Philippe12/HorseSense/horsesense.xlsx

Prj: | horsesense.xml |  |  |  |  |  | Board Qty: | 100
Co.: |  |  |  |  |  |  | Unit Cost: | €27.40
Prj date: | 2025-10-19T16:21:12+0200 |  |  |  |  |  | Total Cost: | €2740.28 |  |  |  |  | €3041.39 | 29 of 29 parts found |  |  |  |  | €2652.00 | 26 of 29 parts found
$ date: | 2025-10-19 16:36:01
Global Part Info |  |  |  |  |  |  |  |  | Digi-Key |  |  |  |  |  | Mouser
Refs | Value | Desc | Footprint | Manf | Manf# | Qty | Unit$ | Ext$ | Avail | Purch | Unit$ | MOQ | Ext$ | Cat# | Avail | Purch | Unit$ | MOQ | Ext$ | Cat#
C1,C3,C19,C23,C25,C30,C32 | 100n | Unpolarized capacitor | C_0805_2012Metric |  | CL21B104KBCNNNC | 700 | €0.005 | €3.50 | 1496000 |  | €0.006 | 1 | €3.90 | 1276-1003-1-ND (https://www.digikey.com/en/products/detail/samsung-electro-mechanics/CL21B104KBCNNNC/3886661) | 1526592 |  | €0.005 | 1 | €3.50 | 187-CL21B104KBCNNNC (https://eu.mouser.com/ProductDetail/Samsung-Electro-Mechanics/CL21B104KBCNNNC?qs=349EhDEZ59pEfpnm5yBEmQ%3D%3D)
C2 | 2.2µ | Unpolarized capacitor | C_0805_2012Metric |  | CL21B225KAFNNNE | 100 | €0.035 | €3.50 | 423908 |  | €0.035 | 1 | €3.54 | 1276-2954-1-ND (https://www.digikey.com/en/products/detail/samsung-electro-mechanics/CL21B225KAFNNNE/3888612) | 33568 |  | €0.035 | 1 | €3.50 | 187-CL21B225KAFNNNE (https://eu.mouser.com/ProductDetail/Samsung-Electro-Mechanics/CL21B225KAFNNNE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)
C4,C9,C10,C12,C18,C22,C33 | 10µ | Unpolarized capacitor | C_0805_2012Metric |  | CL21B106KPQNNNE | 700 | €0.021 | €14.94 | 26373 |  | €0.021 | 1 | €14.94 | 1276-1764-1-ND (https://www.digikey.com/en/products/detail/samsung-electro-mechanics/CL21B106KPQNNNE/3887422) | 162739 |  | €0.041 | 1 | €28.70 | 187-CL21B106KPQNNNE (https://eu.mouser.com/ProductDetail/Samsung-Electro-Mechanics/CL21B106KPQNNNE?qs=yOVawPpwOwnw0R5uMCgpNQ%3D%3D)
C5,C8,C14-C17,C37 | 1µ | Unpolarized capacitor | C_0805_2012Metric |  | CL21B105KAFNFNE | 700 | €0.017 | €11.90 | 94499 |  | €0.018 | 1 | €12.89 | 1276-2926-1-ND (https://www.digikey.com/en/products/detail/samsung-electro-mechanics/CL21B105KAFNFNE/3888584) | 77582 |  | €0.017 | 1 | €11.90 | 187-CL21B105KAFNFNE (https://eu.mouser.com/ProductDetail/Samsung-Electro-Mechanics/CL21B105KAFNFNE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)
C6,C7,C24 | 22µ | Unpolarized capacitor | C_0805_2012Metric |  | GRM21BZ71A226ME15L | 300 | €0.100 | €30.00 | 790570 |  | €0.109 | 1 | €32.82 | 490-GRM21BZ71A226ME15LCT-ND (https://www.digikey.com/en/products/detail/murata-electronics/GRM21BZ71A226ME15L/13904953) | NonStk |  | €0.100 | 1 | €30.00 | 81-GRM21BZ71A226ME5L (https://eu.mouser.com/ProductDetail/Murata-Electronics/GRM21BZ71A226ME15L?qs=Ey7%2FXF42M3ejDq7iqlmWWw%3D%3D)
C11 | 4.7µ | Unpolarized capacitor | C_0805_2012Metric |  | C2012X7R1A475KT000N | 100 | €0.068 | €6.81 | 171009 |  | €0.068 | 1 | €6.81 | 445-7591-1-ND (https://www.digikey.com/en/products/detail/tdk-corporation/C2012X7R1A475K125AC/2733026) | NonStk |  |  |  |  | N/A (https://eu.mouser.com/ProductDetail/TDK/C2012X7R1A475KT000N?qs=chTDxNqvsynaOKmsupj4Xw%3D%3D)
C13 | 47n | Unpolarized capacitor | C_0805_2012Metric |  | 0805B473K500NT | 100 | €0.151 | €15.10 | 2999 |  | €0.839 | 1 | €83.89 | 1763-0805B473K500NTCT-ND (https://www.digikey.com/en/products/detail/knowles-novacap/0805B473K500NT/25702069) | 1310 |  | €0.151 | 1 | €15.10 | 767-0805B473K500NT (https://eu.mouser.com/ProductDetail/Knowles-Novacap/0805B473K500NT?qs=7wMBv%2Ftbz9JoQrUAzLtdOA%3D%3D)
C20,C21 | 33p | Unpolarized capacitor | C_0805_2012Metric |  | CC0805JRNPO9BN330 | 200 | €0.023 | €4.60 | 36849 |  | €0.026 | 1 | €5.27 | 311-1105-1-ND (https://www.digikey.com/en/products/detail/yageo/CC0805JRNPO9BN330/302839) | NonStk |  | €0.023 | 1 | €4.60 | 603-CC805JRNPO9BN330 (https://eu.mouser.com/ProductDetail/YAGEO/CC0805JRNPO9BN330?qs=AgBp2OyFlx9F4YPNsCGomw%3D%3D)
C28,C29 | 100p | Unpolarized capacitor | C_0805_2012Metric |  | GRM2165C1H101JA01D | 200 | €0.033 | €6.60 | 498356 |  | €0.037 | 1 | €7.44 | 490-1615-1-ND (https://www.digikey.com/en/products/detail/murata-electronics/GRM2165C1H101JA01D/586800) | 39028 |  | €0.033 | 1 | €6.60 | 81-GRM40C101J50D (https://eu.mouser.com/ProductDetail/Murata-Electronics/GRM2165C1H101JA01D?qs=IBLLvG%2FZGEX76Y%2F8Q9SJHQ%3D%3D)
C31 | 10n | Unpolarized capacitor | C_0805_2012Metric |  | CL21B103KBANNNC | 100 | €0.006 | €0.59 | 668421 |  | €0.006 | 1 | €0.59 | 1276-1015-1-ND (https://www.digikey.com/en/products/detail/samsung-electro-mechanics/CL21B103KBANNNC/3886673) | 369969 |  | €0.007 | 1 | €0.70 | 187-CL21B103KBANNNC (https://eu.mouser.com/ProductDetail/Samsung-Electro-Mechanics/CL21B103KBANNNC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)
D1-D3 | CT DBLP31.12-6C5D-56-J6U6-20-R18 | Light emitting diode | CTDBLP31126C5D56J6U620R18 |  | CT DBLP31.12-6C5D-56-J6U6-20-R18 | 300 | €0.568 | €170.40 | 5093 |  | €0.612 | 1 | €183.46 | 475-CTDBLP31.12CT-ND (https://www.digikey.com/en/products/detail/ams-osram-usa-inc/CT-DBLP31-12-6C5D-56-J6U6-20-R18/17628909) | 3994 |  | €0.568 | 1 | €170.40 | 720-CTDB6C5D56J6U620 (https://eu.mouser.com/ProductDetail/ams-OSRAM/CT-DBLP31.12-6C5D-56-J6U6-20-R18?qs=vLWxofP3U2xgbqKYEOstuw%3D%3D)
D4,D6 | VEMD8080 |  | XDCR_VEMD8080 | VISHAY | VEMD8080 (https://www.vishay.com/docs/84565/vemd8080.pdf) | 200 | €0.869 | €173.80 | 4541 |  | €1.162 | 1 | €232.48 | VEMD8080CT-ND (https://www.digikey.com/en/products/detail/vishay-semiconductor-opto-division/VEMD8080/8602378) | 37930 |  | €0.869 | 1 | €173.80 | 78-VEMD8080 (https://eu.mouser.com/ProductDetail/Vishay-Semiconductors/VEMD8080?qs=F5EMLAvA7IBCchs2bw9l%2Fw%3D%3D)
J1 | USB4105-GF-A-120 | USB 2.0-only 14P Type-C Receptacle connector | USB_C_Receptacle_GCT_USB4105-xx-A_16P_TopMnt_Horizontal |  | USB4105-GF-A-120 (https://www.usb.org/sites/default/files/documents/usb_type-c.zip) | 100 | €0.443 | €44.30 | 17061 |  | €0.519 | 1 | €51.94 | 2073-USB4105-GF-A-120CT-ND (https://www.digikey.com/en/products/detail/gct/USB4105-GF-A-120/14559037) | 82889 |  | €0.443 | 1 | €44.30 | 640-USB4105-GF-A-120 (https://eu.mouser.com/ProductDetail/GCT/USB4105-GF-A-120?qs=QNEnbhJQKva%252Bjxw%2FpEjDhQ%3D%3D)
J3 | 73412-0110 | coaxial connector (BNC, SMA, SMB, SMC, Cinch/RCA, LEMO, ...) | U.FL_Molex_MCRF_73412-0110_Vertical |  | 73412-0110 | 100 | €0.483 | €48.30 | 110105 |  | €0.533 | 1 | €53.26 | WM5587CT-ND (https://www.digikey.com/en/products/detail/molex/0734120110/1894611) | NonStk |  | €0.483 | 1 | €48.30 | 538-73412-0110 (https://eu.mouser.com/ProductDetail/Molex/73412-0110?qs=NlNVDDZd7xQHV8e0ilpSdQ%3D%3D)
L1 | 1µ | Inductor | L_0805_2012Metric |  | LQM21PH1R0NGCD | 100 | €0.132 | €13.20 | 7490 |  | €0.143 | 1 | €14.28 | 490-18468-1-ND (https://www.digikey.com/en/products/detail/murata-electronics/LQM21PH1R0NGCD/10135259) | 14563 |  | €0.132 | 1 | €13.20 | 81-LQM21PH1R0NGCD (https://eu.mouser.com/ProductDetail/Murata-Electronics/LQM21PH1R0NGCD?qs=17u8i%2FzlE8%252BENrjyNDhWgQ%3D%3D)
L2 | 68nH | Inductor with iron core, small symbol | L_0805_2012Metric |  | MLF2012D68NMTD25 | 100 | €0.092 | €9.20 | 5061 |  | €0.099 | 1 | €9.86 | 445-16980-1-ND (https://www.digikey.com/en/products/detail/tdk-corporation/MLF2012D68NMTD25/4743105) | 4199 |  | €0.092 | 1 | €9.20 | 810-MLF2012D68NMTD25 (https://eu.mouser.com/ProductDetail/TDK/MLF2012D68NMTD25?qs=u4%252BEJ9urDATSIFVN0NofiA%3D%3D)
MT1 | ICM-42670-P |  | XDCR_ICM-42670-P | TDK InvenSense | ICM-42670-P (https://invensense.tdk.com/download-pdf/icm-42670-p-datasheet/) | 100 | €2.220 | €222.00 | 8770 |  | €2.534 | 1 | €253.37 | 1428-ICM-42670-PCT-ND (https://www.digikey.com/en/products/detail/tdk-invensense/ICM-42670-P/14319524) | 7299 |  | €2.220 | 1 | €222.00 | 410-ICM-42670-P (https://eu.mouser.com/ProductDetail/TDK-InvenSense/ICM-42670-P?qs=iLbezkQI%252BsgK8sMF5V7fQQ%3D%3D)
R1,R2 | 5.1k | Resistor | R_0805_2012Metric |  | RK73H2ATTD5101F | 200 | €0.011 | €2.20 | 39708 |  | €0.015 | 1 | €2.95 | 2019-RK73H2ATTD5101FCT-ND (https://www.digikey.com/en/products/detail/koa-speer-electronics-inc/RK73H2ATTD5101F/10234175) | 39096 |  | €0.011 | 1 | €2.20 | 660-RK73H2ATTD5101F (https://eu.mouser.com/ProductDetail/KOA-Speer/RK73H2ATTD5101F?qs=qdbN2r920CXERR4aJasjig%3D%3D)
R3-R6,R29 | 10k | Resistor | R_0805_2012Metric |  | RK73H2ATTD1002F | 500 | €0.010 | €4.88 | 502198 |  | €0.010 | 1 | €4.88 | 2019-RK73H2ATTD1002FCT-ND (https://www.digikey.com/en/products/detail/koa-speer-electronics-inc/RK73H2ATTD1002F/10234111) | 1234351 |  | €0.011 | 1 | €5.50 | 660-RK73H2ATTD1002F (https://eu.mouser.com/ProductDetail/KOA-Speer/RK73H2ATTD1002F?qs=tLTLU8dkiwvc%2FyU3ERoqnw%3D%3D)
R7 | 0 | Resistor | R_0805_2012Metric |  | RC0805JR-7W0RL | 100 | €0.011 | €1.10 | 2116 |  | €0.016 | 1 | €1.59 | 13-RC0805JR-7W0RLCT-ND (https://www.digikey.com/en/products/detail/yageo/RC0805JR-7W0RL/12698815) | 43015 |  | €0.011 | 1 | €1.10 | 603-RC0805JR-7W0RL (https://eu.mouser.com/ProductDetail/YAGEO/RC0805JR-7W0RL?qs=tggtontpCXOvGhG2gs4kMQ%3D%3D)
SW1,SW2 | EVQ-P7A01P | Omron B3FS 6x6mm single pole normally-open tactile switch | SW_SPST_EVQP7A |  | EVQ-P7A01P (https://omronfs.omron.com/en_US/ecb/products/pdf/en-b3fs.pdf) | 200 | €0.160 | €32.00 | 45265 |  | €0.191 | 1 | €38.16 | P16763CT-ND (https://www.digikey.com/en/products/detail/panasonic-electronic-components/EVQ-P7A01P/4429447) | 15951 |  | €0.160 | 1 | €32.00 | 667-EVQP7A01P (https://eu.mouser.com/ProductDetail/Panasonic/EVQ-P7A01P?qs=rJ%252BziJWpysz7n3C20u6WAw%3D%3D)
U1 | MAX86141ENP+T |  | 21-100134_N201A2-1_MXM |  | MAX86141ENP+T | 100 | €6.210 | €621.00 | 4873 |  | €6.345 | 1 | €634.55 | MAX86141ENP+TCT-ND (https://www.digikey.com/en/products/detail/analog-devices-inc-maxim-integrated/MAX86141ENP-T/7804058) | 8768 |  | €6.210 | 1 | €621.00 | 700-MAX86141ENP+T (https://eu.mouser.com/ProductDetail/Analog-Devices-Maxim-Integrated/MAX86141ENP%2bT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)
U2 | TXB0304RUTR | 4-Bit Bidirectional Voltage-Level Translator, Auto Direction Sensing, 0.9 - 3.6V APort, 0.9 - 3.6V BPort, Active High Output Enable, Texas_PUQFN-12 | Texas_R-PUQFN-N12 |  | TXB0304RUTR (http://www.ti.com/lit/ds/symlink/txb0304.pdf) | 100 | €0.476 | €47.60 | 7676 |  | €0.513 | 1 | €51.32 | 296-29682-1-ND (https://www.digikey.com/en/products/detail/texas-instruments/TXB0304RUTR/2762235) | 29040 |  | €0.476 | 1 | €47.60 | 595-TXB0304RUTR (https://eu.mouser.com/ProductDetail/Texas-Instruments/TXB0304RUTR?qs=bhx7MkwkKU%252BRFcNlao4SmA%3D%3D)
U3 | BQ25601 | I2C Controlled 3A Single-Cell Battery Charger for High Input Voltage and Narrow Voltage DC Power Path Management, WQFN-32 | Texas_RTW_WQFN-24-1EP_4x4mm_P0.5mm_EP2.7x2.7mm_ThermalVias |  | BQ25601DRTWR (http://www.ti.com/lit/ds/symlink/bq25601.pdf) | 100 | €1.680 | €168.00 | 10132 |  | €1.814 | 1 | €181.42 | 296-BQ25601DRTWRCT-ND (https://www.digikey.com/en/products/detail/texas-instruments/BQ25601DRTWR/9597826) | 977 |  | €1.680 | 1 | €168.00 | 595-BQ25601DRTWR (https://eu.mouser.com/ProductDetail/Texas-Instruments/BQ25601DRTWR?qs=w%2Fv1CP2dgqrIFVXOqACIAg%3D%3D)
U4 | XC6210B332MR | 700mA, Low Drop-out Voltage Regulator, Fixed Output 3.3V, SOT-23-5 | SOT-23-5 |  | XC6210B332MR (https://www.torexsemi.com/file/xc6210/XC6210.pdf) | 100 | €0.480 | €47.98 | 57377 |  | €0.480 | 1 | €47.98 | 893-1075-1-ND (https://www.digikey.com/en/products/detail/torex-semiconductor-ltd/XC6210B332MR-G/2138119) | NonStk |  |  |  |  | N/A (https://eu.mouser.com/ProductDetail/Torex-Semiconductor/XC6210B332MR?qs=TiOZkKH1s2RnKp%252BMGbUSuQ%3D%3D)
U5 | XC6210B182MR | 700mA, Low Drop-out Voltage Regulator, Fixed Output 3.3V, SOT-23-5 | SOT-23-5 |  | XC6210B182MR (https://www.torexsemi.com/file/xc6210/XC6210.pdf) | 100 | €0.480 | €47.98 | 5294 |  | €0.480 | 1 | €47.98 | 893-1072-1-ND (https://www.digikey.com/en/products/detail/torex-semiconductor-ltd/XC6210B182MR-G/2138116) | NonStk |  |  |  |  | N/A (https://eu.mouser.com/ProductDetail/Torex-Semiconductor/XC6210B182MR?qs=TiOZkKH1s2TLQjPgSN8%2F1g%3D%3D)
U6 | LC76GPAMD |  | Package | Quectel | LC76GPAMD (https://mm.digikey.com/Volume0/opasdata/d220001/medias/docus/7133/Quectel_LC76G_Series_GNSS_Specification_V1.1-1-1.pdf) | 100 | €5.400 | €540.00 | 1782 |  | €5.826 | 1 | €582.55 | 2958-LC76GPAMDCT-ND (https://www.digikey.com/en/products/detail/quectel/LC76GPAMD/21272484) | 1212 |  | €5.400 | 1 | €540.00 | 277-LC76GPAMD (https://eu.mouser.com/ProductDetail/Quectel/LC76GPAMD?qs=vvQtp7zwQdMfDuCTmjRUww%3D%3D)
U7 | AP22804AW5-7 | Current limited 2.5A power switch, single channel, SOT-23-5 | SOT-23-5 |  | AP22804AW5-7 (https://www.diodes.com/assets/Datasheets/AP22804_14.pdf) | 100 | €0.158 | €15.80 | 237574 |  | €0.170 | 1 | €17.05 | AP22804AW5-7DICT-ND (https://www.digikey.com/en/products/detail/diodes-incorporated/AP22804AW5-7/6602435) | 43139 |  | €0.158 | 1 | €15.80 | 621-AP22804AW5-7 (https://eu.mouser.com/ProductDetail/Diodes-Incorporated/AP22804AW5-7?qs=lqAf%2FiVYw9hgcUuNhFapmA%3D%3D)
U9 | ESP32-S3-WROOM-1-N16R8 | RF Module, ESP32-S3 SoC, Wi-Fi 802.11b/g/n, Bluetooth, BLE, 32-bit, 3.3V, onboard antenna, SMD | ESP32-S3-WROOM-1 |  | ESP32-S3-WROOM-1-N16R8 (https://www.espressif.com/sites/default/files/documentation/esp32-s3-wroom-1_wroom-1u_datasheet_en.pdf) | 100 | €4.330 | €433.00 | 12045 |  | €4.602 | 1 | €460.21 | 5407-ESP32-S3-WROOM-1-N16R8CT-ND (https://www.digikey.com/en/products/detail/espressif-systems/ESP32-S3-WROOM-1-N16R8/16162642) | 9029 |  | €4.330 | 1 | €433.00 | 356-ESP32S3WRM1N16R8 (https://eu.mouser.com/ProductDetail/Espressif-Systems/ESP32-S3-WROOM-1-N16R8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)
 | Used currency rates: |  |  |  |  |  | Total Purchase: | €0.00 | Buy here (https://www.digikey.com/ordering/shoppingcart) |  |  |  | €0.00 |  | Buy here (https://mouser.com/bom/) |  |  |  | €0.00
 | EUR(€)/USD($): | 0.9279881218 |  |  |  |  | Purchase description:
KiCost® v1.1.19
