Philippe12/HorseSense/horsesense.kicad_pcb

## KiCad design horsesense.kicad_pcb (2026-08-13)

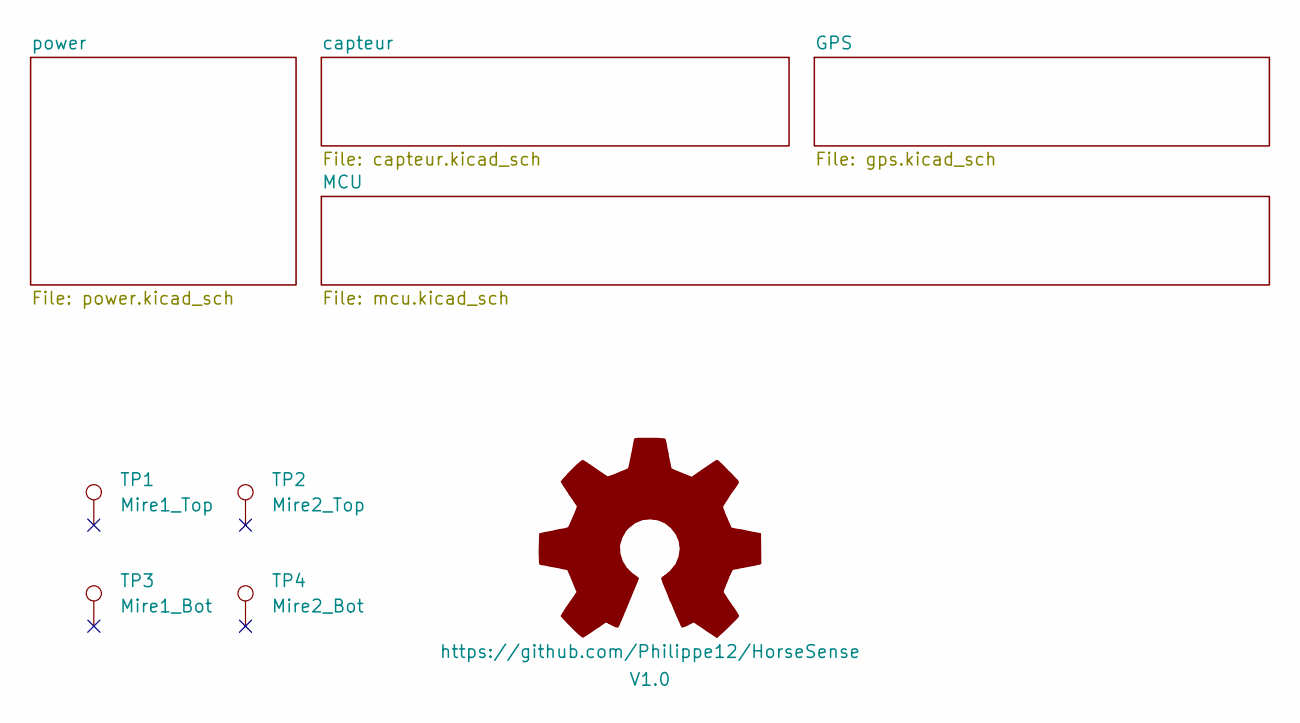
[picture p1: schematic horsesense.kicad_sch]

Parts:
SYM1: https://github.com/Philippe12/HorseSense; OSHW-Symbol_13.4x12mm_SilkScreen
TP1: Mire1_Top; TestPoint_Pad_D1.0mm
TP2: Mire2_Top; TestPoint_Pad_D1.0mm
TP3: Mire1_Bot; TestPoint_Pad_D1.0mm
TP4: Mire2_Bot; TestPoint_Pad_D1.0mm

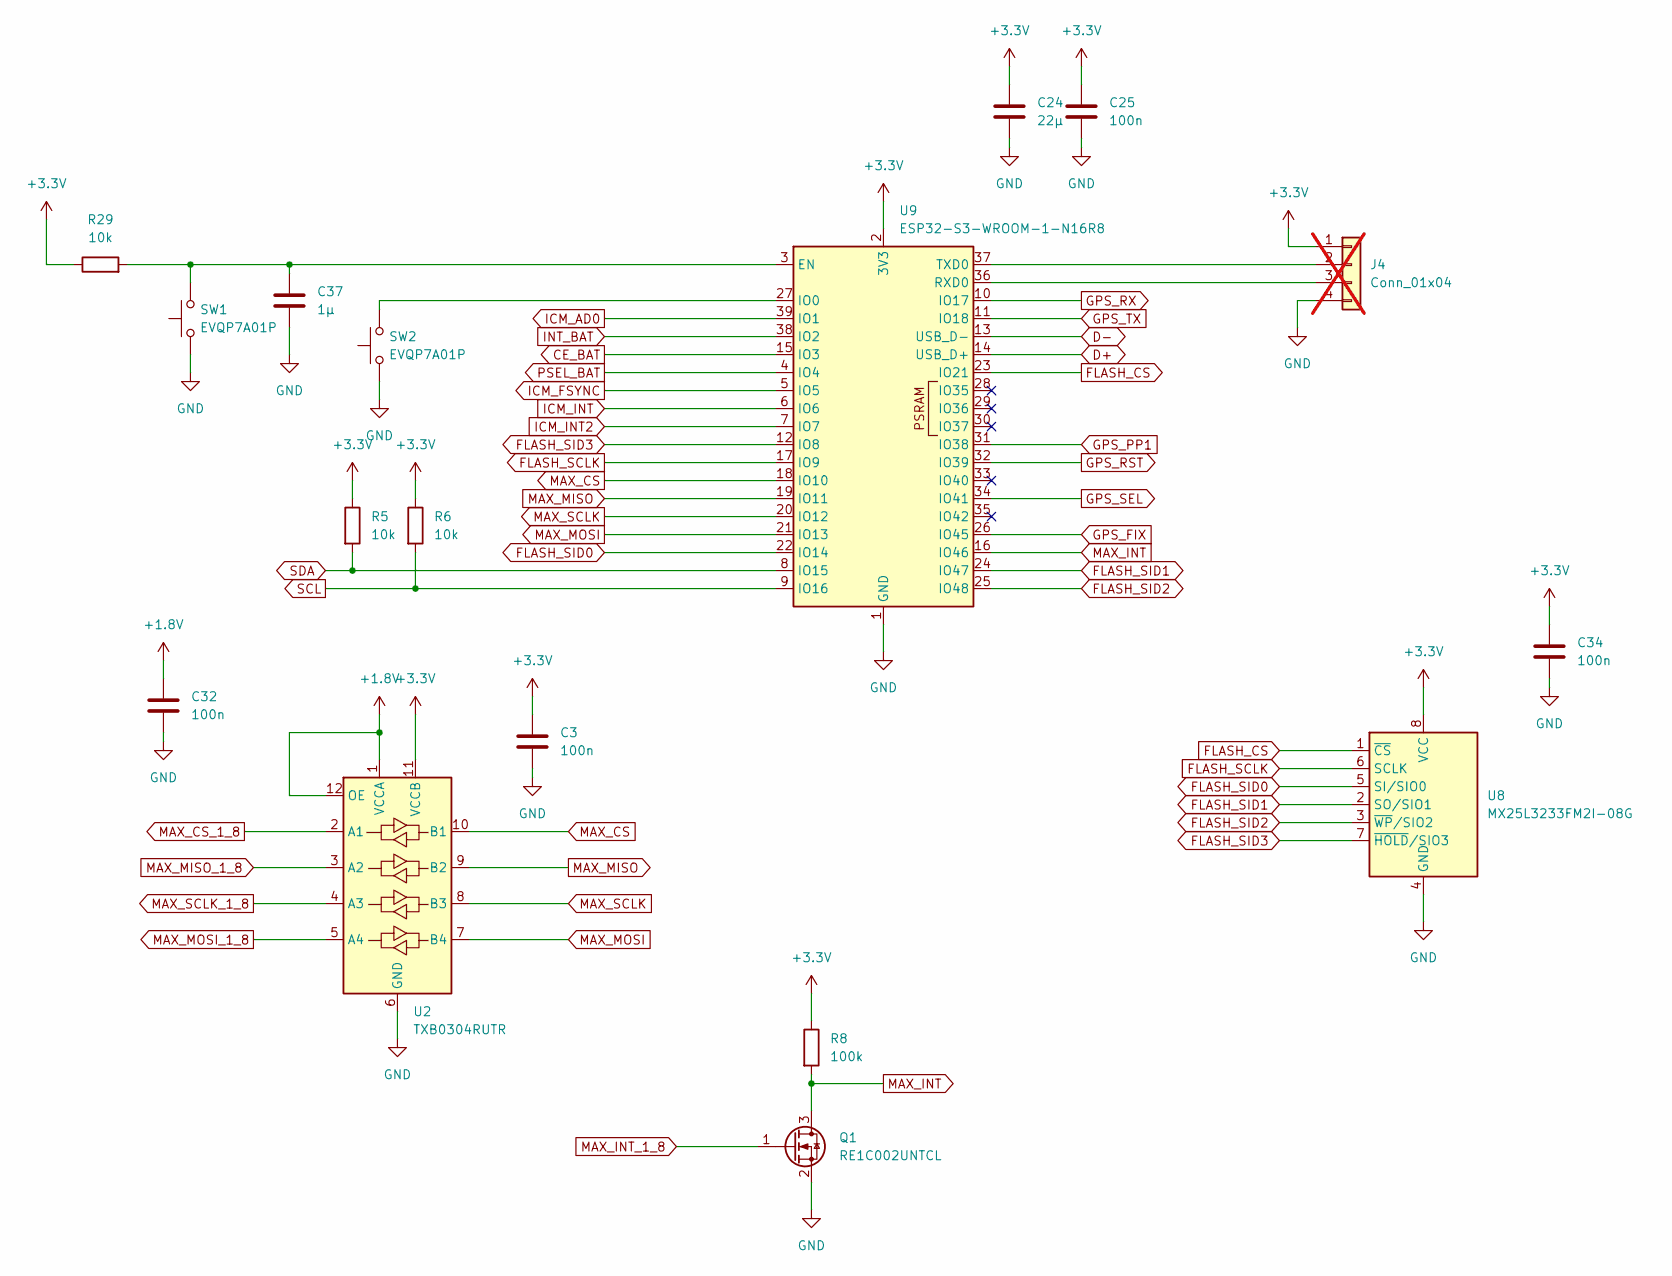
[picture p2: schematic mcu.kicad_sch, HorseSense]

Parts:
C3, C25, C32, C34: 100n; C_0805_2012Metric; JLCPCB Part # C1711
C24: 22µ; C_0805_2012Metric; JLCPCB Part # C907991
C37: 1µ; C_0805_2012Metric; JLCPCB Part # C1712
J4: Conn_01x04; PinHeader_1x04_P1.27mm_Vertical; not fitted
Q1: RE1C002UNTCL; SOT-416; JLCPCB Part # C509959
R5, R6, R29: 10k; R_0805_2012Metric; JLCPCB Part # C276215
R8: 100k; R_0805_2012Metric; JLCPCB Part # C25271
SW1, SW2: EVQP7A01P; SW_SPST_EVQP7A; JLCPCB Part # C79167
U2: TXB0304RUTR; Texas_R-PUQFN-N12; JLCPCB Part # C69598
U8: MX25L3233FM2I-08G; SOIC-8_5.3x5.3mm_P1.27mm; JLCPCB Part # C190802
U9: ESP32-S3-WROOM-1-N16R8; ESP32-S3-WROOM-1; JLCPCB Part # C2913202

Connections:
+1.8V: C32.1, U2.1 (VCCA), U2.12 (OE); also elsewhere on the board
+3.3V: C3.1, C24.1, C25.1, C34.1, J4.1, R5.1, R6.1, R8.1, R29.1, U2.11 (VCCB), U8.8 (VCC), U9.2 (3V3); also elsewhere on the board
CE_BAT: U9.15 (IO3); also elsewhere on the board
D+: U9.14 (USB_D+); also elsewhere on the board
D-: U9.13 (USB_D-); also elsewhere on the board
FLASH_CS: U8.1 (~CS), U9.23 (IO21)
FLASH_SCLK: U8.6 (SCLK), U9.17 (IO9)
FLASH_SID0: U8.5 (SI/SIO0), U9.22 (IO14)
FLASH_SID1: U8.2 (SO/SIO1), U9.24 (IO47)
FLASH_SID2: U8.3 (~WP/SIO2), U9.25 (IO48)
FLASH_SID3: U8.7 (~HOLD/SIO3), U9.12 (IO8)
GND: C3.2, C24.2, C25.2, C32.2, C34.2, C37.2, J4.4, Q1.2 (S), SW1.1, SW2.1, U2.6 (GND), U8.4 (GND), U9.1 (GND), U9.40 (GND), U9.41 (GND); also elsewhere on the board
GPS_FIX: U9.26 (IO45); also elsewhere on the board
GPS_PP1: U9.31 (IO38); also elsewhere on the board
GPS_RST: U9.32 (IO39); also elsewhere on the board
GPS_RX: U9.10 (IO17); also elsewhere on the board
GPS_SEL: U9.34 (IO41); also elsewhere on the board
GPS_TX: U9.11 (IO18); also elsewhere on the board
ICM_AD0: U9.39 (IO1); also elsewhere on the board
ICM_FSYNC: U9.5 (IO5); also elsewhere on the board
ICM_INT: U9.6 (IO6); also elsewhere on the board
ICM_INT2: U9.7 (IO7); also elsewhere on the board
INT_BAT: U9.38 (IO2); also elsewhere on the board
MAX_CS: U2.10 (B1), U9.18 (IO10)
MAX_CS_1_8: U2.2 (A1); also elsewhere on the board
MAX_INT: Q1.3 (D), R8.2, U9.16 (IO46)
MAX_INT_1_8: Q1.1 (G); also elsewhere on the board
MAX_MISO: U2.9 (B2), U9.19 (IO11)
MAX_MISO_1_8: U2.3 (A2); also elsewhere on the board
MAX_MOSI: U2.7 (B4), U9.21 (IO13)
MAX_MOSI_1_8: U2.5 (A4); also elsewhere on the board
MAX_SCLK: U2.8 (B3), U9.20 (IO12)
MAX_SCLK_1_8: U2.4 (A3); also elsewhere on the board
unnamed: J4.2, U9.37 (TXD0)
unnamed: J4.3, U9.36 (RXD0)
unnamed: C37.1, R29.2, SW1.2, U9.3 (EN)
unnamed: SW2.2, U9.27 (IO0)
PSEL_BAT: U9.4 (IO4); also elsewhere on the board
SCL: R6.2, U9.9 (IO16); also elsewhere on the board
SDA: R5.2, U9.8 (IO15); also elsewhere on the board

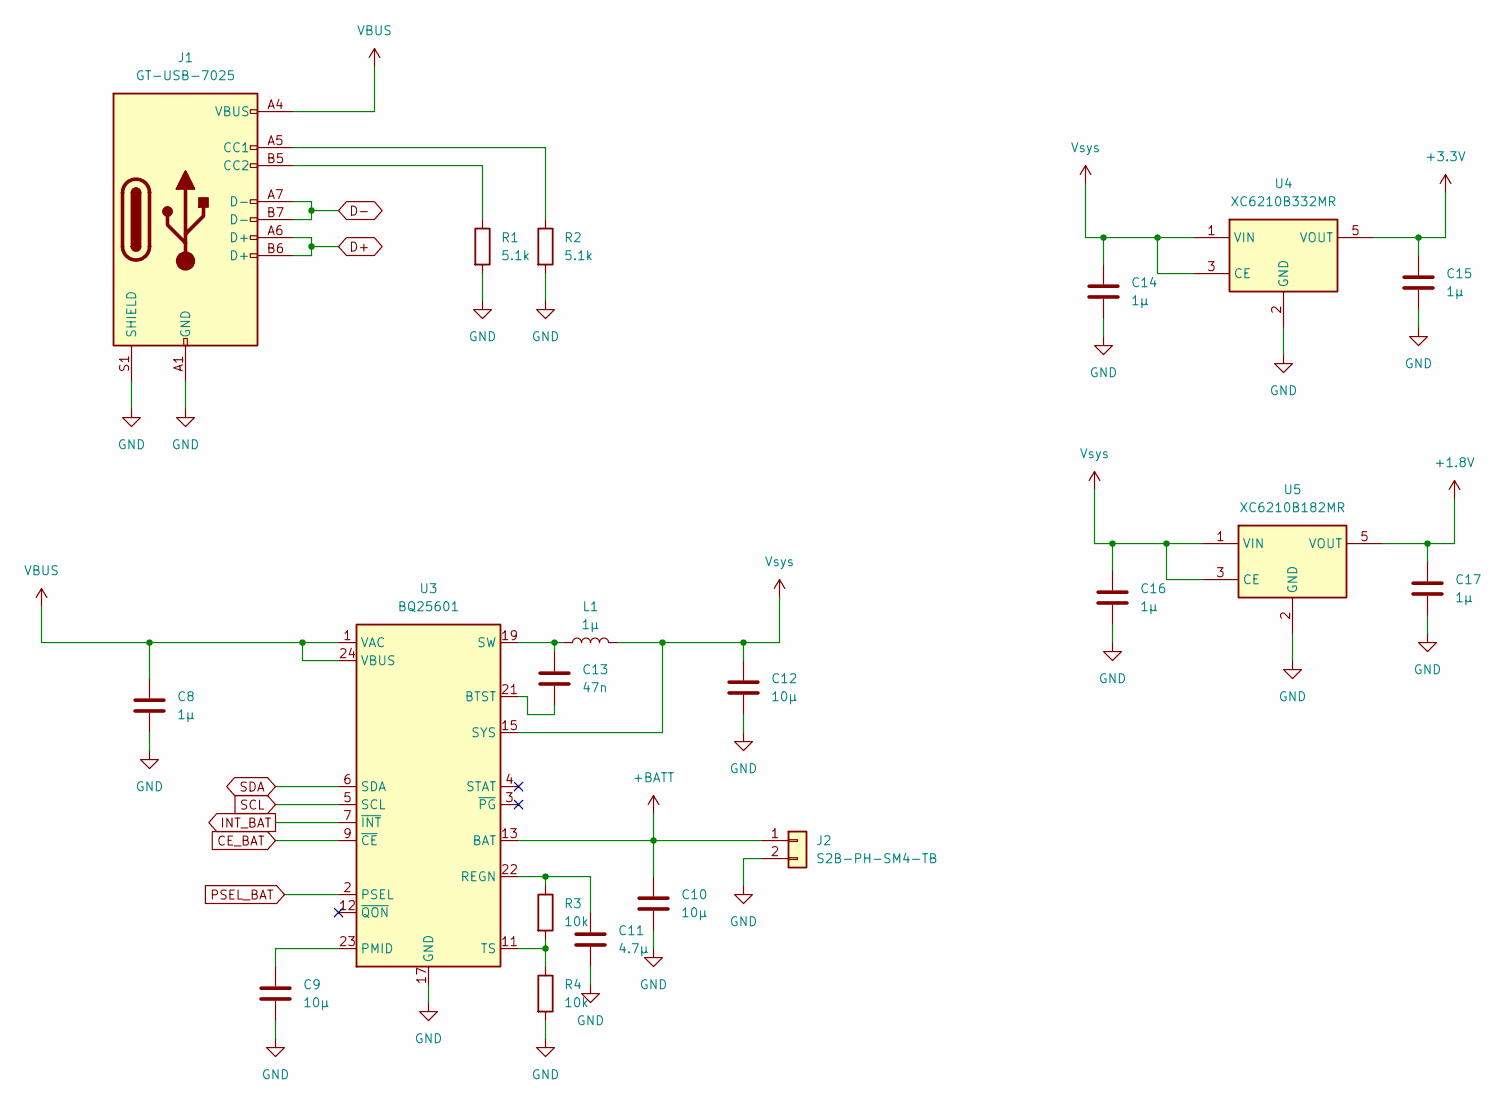
[picture p3: schematic power.kicad_sch, HorseSense]

Parts:
C8, C14, C15, C16, C17: 1µ; C_0805_2012Metric; JLCPCB Part # C1712
C9, C10, C12: 10µ; C_0805_2012Metric; JLCPCB Part # C32635
C11: 4.7µ; C_0805_2012Metric; JLCPCB Part # C76639
C13: 47n; C_0805_2012Metric; JLCPCB Part # C1745
J1: GT-USB-7025; USB_C_Receptacle_GCT_USB4105-xx-A_16P_TopMnt_Horizontal; JLCPCB Part # C27636760
J2: S2B-PH-SM4-TB; JST_PH_S2B-PH-SM4-TB_1x02-1MP_P2.00mm_Horizontal; JLCPCB Part # C295747
L1: 1µ; L_0805_2012Metric; JLCPCB Part # C383371
R1, R2: 5.1k; R_0805_2012Metric; JLCPCB Part # C27834
R3, R4: 10k; R_0805_2012Metric; JLCPCB Part # C276215
U3: BQ25601; Texas_RTW_WQFN-24-1EP_4x4mm_P0.5mm_EP2.7x2.7mm_ThermalVias; JLCPCB Part # C2859691
U4: XC6210B332MR; SOT-23-5; JLCPCB Part # C424705
U5: XC6210B182MR; SOT-23-5; JLCPCB Part # C2983925

Connections:
+1.8V: C17.1, U5.5 (VOUT); also elsewhere on the board
+3.3V: C15.1, U4.5 (VOUT); also elsewhere on the board
+BATT: C10.1, J2.1, U3.13 (BAT), U3.14 (BAT)
CE_BAT: U3.9 (~CE); also elsewhere on the board
D+: J1.A6 (D+), J1.B6 (D+); also elsewhere on the board
D-: J1.A7 (D-), J1.B7 (D-); also elsewhere on the board
GND: C8.2, C9.2, C10.2, C11.2, C12.2, C14.2, C15.2, C16.2, C17.2, J1.A1 (GND), J1.A12 (GND), J1.B1 (GND), J1.B12 (GND), J1.S1 (SHIELD), J2.2, R1.2, R2.2, R4.2, U3.17 (GND), U3.18 (GND), U3.25 (GND), U4.2 (GND), U5.2 (GND); also elsewhere on the board
INT_BAT: U3.7 (~INT); also elsewhere on the board
unnamed: C13.1, L1.1, U3.19 (SW), U3.20 (SW)
unnamed: J1.A5 (CC1), R2.1
unnamed: J1.B5 (CC2), R1.1
unnamed: C13.2, U3.21 (BTST)
unnamed: C9.1, U3.23 (PMID)
unnamed: C11.1, R3.1, U3.22 (REGN)
unnamed: R3.2, R4.1, U3.11 (TS)
PSEL_BAT: U3.2 (PSEL); also elsewhere on the board
SCL: U3.5 (SCL); also elsewhere on the board
SDA: U3.6 (SDA); also elsewhere on the board
VBUS: C8.1, J1.A4 (VBUS), J1.A9 (VBUS), J1.B4 (VBUS), J1.B9 (VBUS), U3.1 (VAC), U3.24 (VBUS)
Vsys: C12.1, C14.1, C16.1, L1.2, U3.15 (SYS), U3.16 (SYS), U4.1 (VIN), U4.3 (CE), U5.1 (VIN), U5.3 (CE)

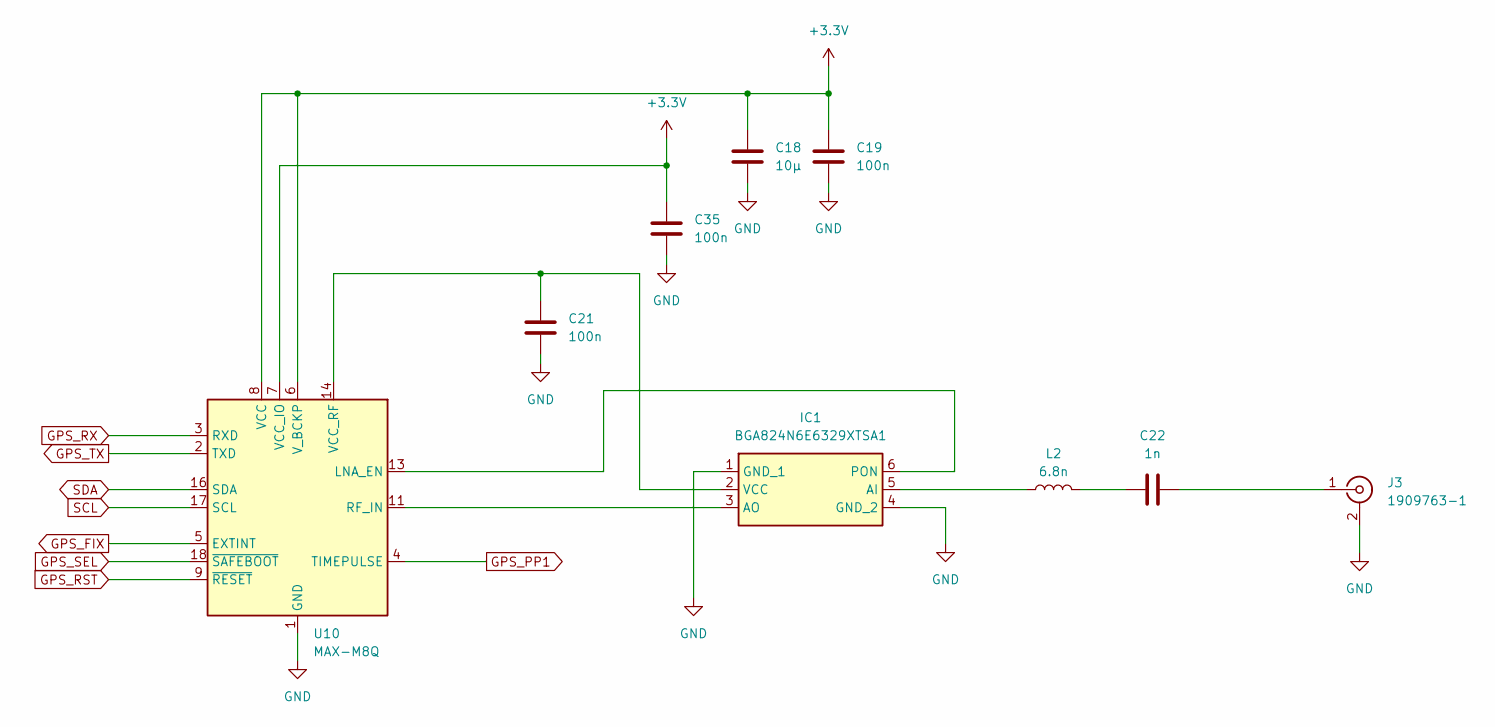
[picture p4: schematic gps.kicad_sch, HorseSense]

Parts:
C18: 10µ; C_0805_2012Metric; JLCPCB Part # C32635
C19, C21, C35: 100n; C_0805_2012Metric; JLCPCB Part # C1711
C22: 1n; C_0805_2012Metric; JLCPCB Part # C46653
IC1: BGA824N6E6329XTSA1; Mouser Part Number 726-BGA824N6E6329XTS
J3: 1909763-1; U.FL_Molex_MCRF_73412-0110_Vertical; JLCPCB Part # 1909763-1
L2: 6.8n; L_0805_2012Metric; JLCPCB Part # C701176
U10: MAX-M8Q; ublox_MAX; JLCPCB Part # C6898733

Connections:
+3.3V: C18.1, C19.1, C35.1, U10.6 (V_BCKP), U10.7 (VCC_IO), U10.8 (VCC); also elsewhere on the board
GND: C18.2, C19.2, C21.2, C35.2, IC1.1 (GND_1), IC1.4 (GND_2), J3.2 (Ext), U10.1 (GND), U10.10 (GND), U10.12 (GND); also elsewhere on the board
GPS_FIX: U10.5 (EXTINT); also elsewhere on the board
GPS_PP1: U10.4 (TIMEPULSE); also elsewhere on the board
GPS_RST: U10.9 (~RESET); also elsewhere on the board
GPS_RX: U10.3 (RXD); also elsewhere on the board
GPS_SEL: U10.18 (~SAFEBOOT); also elsewhere on the board
GPS_TX: U10.2 (TXD); also elsewhere on the board
unnamed: C22.1, L2.2
unnamed: IC1.5 (AI), L2.1
unnamed: IC1.3 (AO), U10.11 (RF_IN)
unnamed: IC1.6 (PON), U10.13 (LNA_EN)
unnamed: C21.1, IC1.2 (VCC), U10.14 (VCC_RF)
unnamed: C22.2, J3.1 (In)
SCL: U10.17 (SCL); also elsewhere on the board
SDA: U10.16 (SDA); also elsewhere on the board

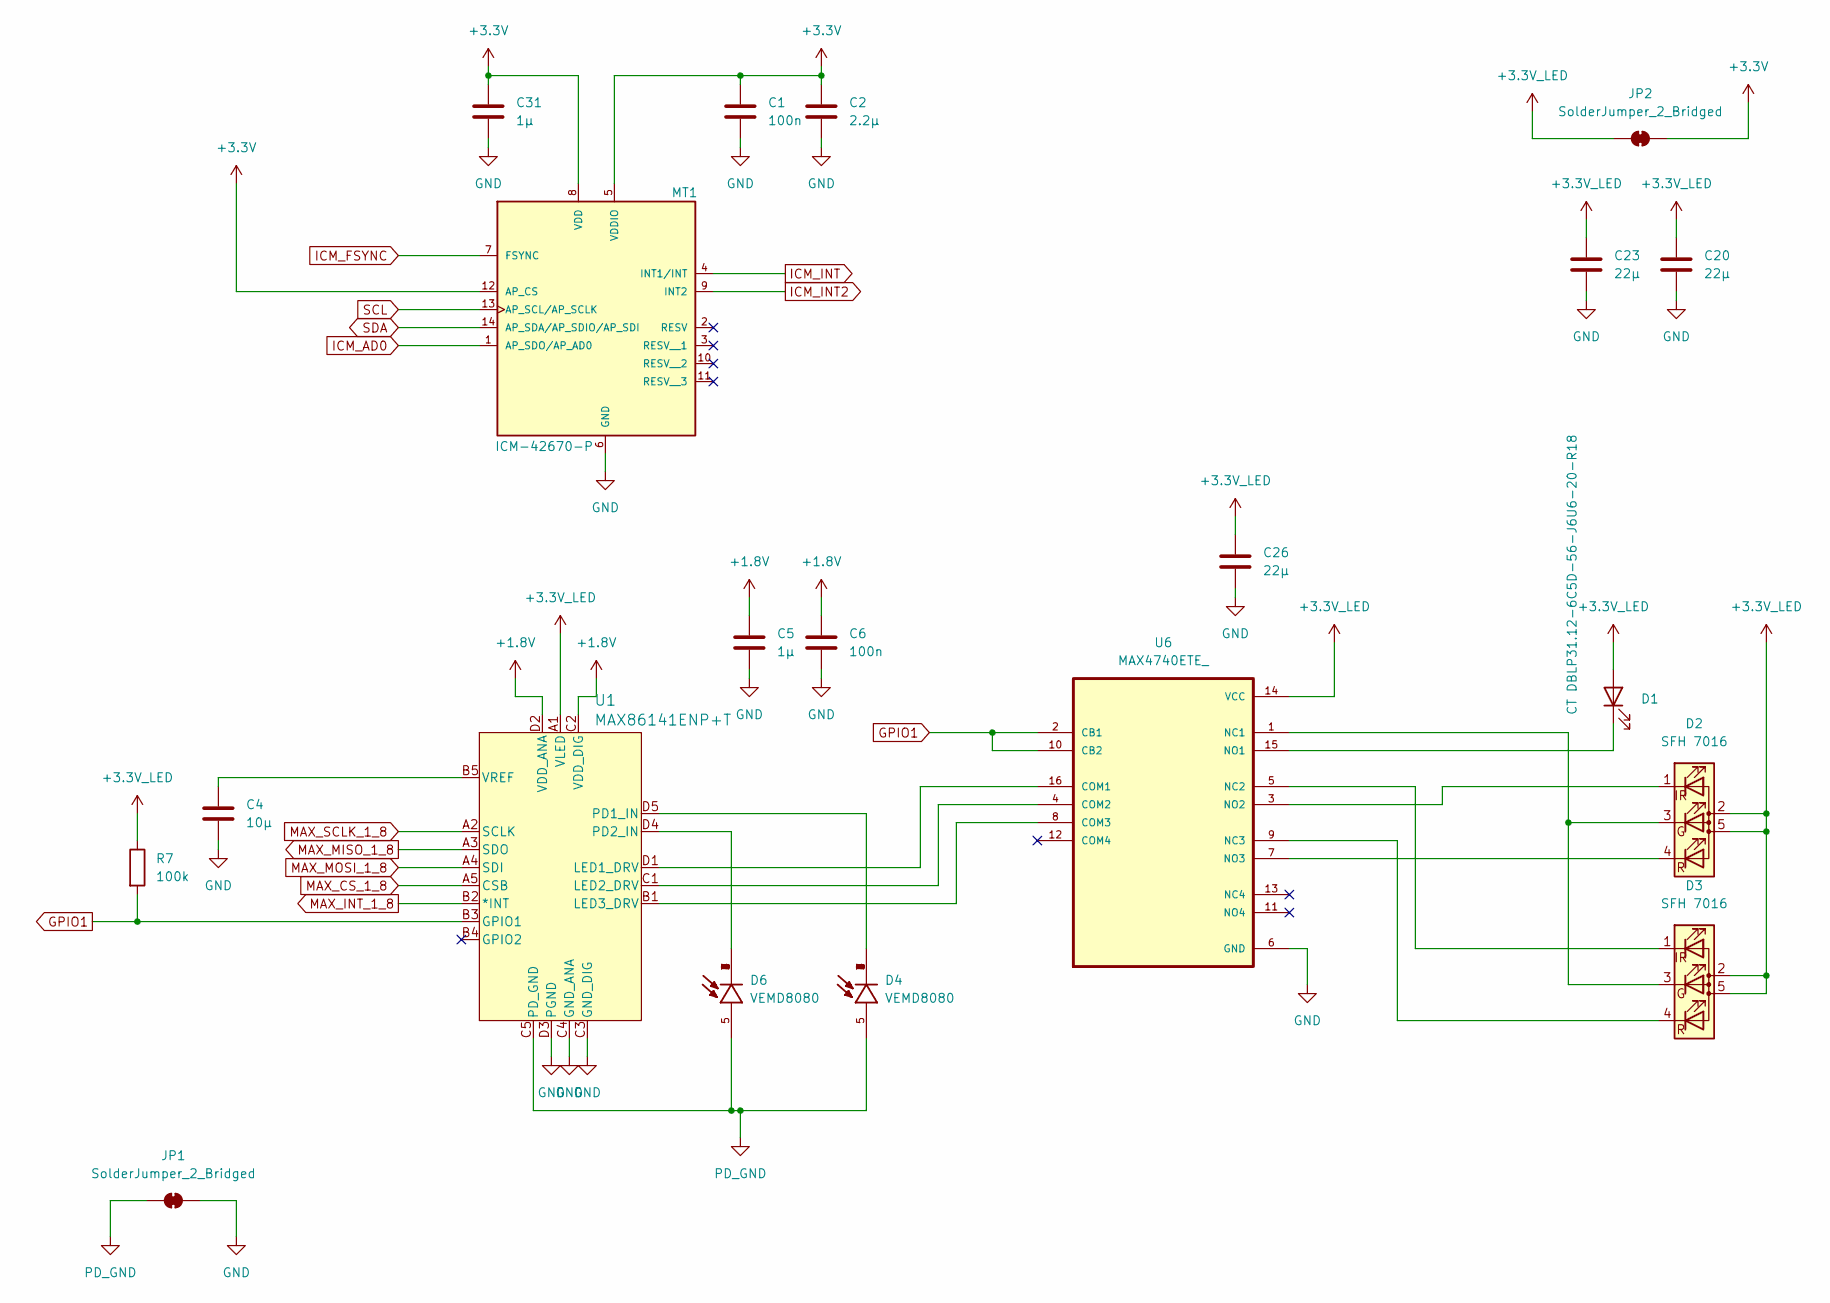
[picture p5: schematic capteur.kicad_sch, HorseSense]

Parts:
C1, C6: 100n; C_0805_2012Metric; JLCPCB Part # C1711
C2: 2.2µ; C_0805_2012Metric; JLCPCB Part # C19110
C4: 10µ; C_0805_2012Metric; JLCPCB Part # C32635
C5, C31: 1µ; C_0805_2012Metric; JLCPCB Part # C1712
C20, C23, C26: 22µ; C_0805_2012Metric; JLCPCB Part # C907991
D1: CT DBLP31.12-6C5D-56-J6U6-20-R18; CTDBLP31126C5D56J6U620R18; JLCPCB Part # C5603826
D2, D3: SFH 7016; SFH7016; JLCPCB Part # C2900452
D4, D6: VEMD8080; XDCR_VEMD8080; PARTREV 1.0; JLCPCB Part # C511402
JP1, JP2: SolderJumper_2_Bridged; SolderJumper-2_P1.3mm_Bridged2Bar_RoundedPad1.0x1.5mm
MT1: ICM-42670-P; XDCR_ICM-42670-P; PARTREV 1.1; JLCPCB Part # C3288646
R7: 100k; R_0805_2012Metric; JLCPCB Part # C25271
U1: MAX86141ENP+T; 21-100134_N201A2-1_MXM; JLCPCB Part # C5328762
U6: MAX4740ETE_; QFN50P300X300X80-17N; DigiKey_Part_Number MAX4740ETE+-ND

Connections:
+1.8V: C5.1, C6.1, U1.C2 (VDD_DIG), U1.D2 (VDD_ANA); also elsewhere on the board
+3.3V: C1.1, C2.1, C31.1, JP2.2 (B), MT1.5 (VDDIO), MT1.8 (VDD), MT1.12 (AP_CS); also elsewhere on the board
+3.3V_LED: C20.1, C23.1, C26.1, D1.1 (A), D2.2 (A), D2.5 (A), D3.2 (A), D3.5 (A), JP2.1 (A), R7.1, U1.A1 (VLED), U6.14 (VCC)
GND: C1.2, C2.2, C4.2, C5.2, C6.2, C20.2, C23.2, C26.2, C31.2, JP1.2 (B), MT1.6 (GND), U1.C3 (GND_DIG), U1.C4 (GND_ANA), U1.D3 (PGND), U6.6 (GND), U6.17 (GND); also elsewhere on the board
GPIO1: R7.2, U1.B3 (GPIO1), U6.2 (CB1), U6.10 (CB2)
ICM_AD0: MT1.1 (AP_SDO/AP_AD0); also elsewhere on the board
ICM_FSYNC: MT1.7 (FSYNC); also elsewhere on the board
ICM_INT: MT1.4 (INT1/INT); also elsewhere on the board
ICM_INT2: MT1.9 (INT2); also elsewhere on the board
MAX_CS_1_8: U1.A5 (CSB); also elsewhere on the board
MAX_INT_1_8: U1.B2 (*INT); also elsewhere on the board
MAX_MISO_1_8: U1.A3 (SDO); also elsewhere on the board
MAX_MOSI_1_8: U1.A4 (SDI); also elsewhere on the board
MAX_SCLK_1_8: U1.A2 (SCLK); also elsewhere on the board
unnamed: D1.2 (K), U6.15 (NO1)
unnamed: D2.4 (BK), U6.7 (NO3)
unnamed: D2.3 (GK), D3.3 (GK), U6.1 (NC1)
unnamed: D2.1 (RK), U6.3 (NO2)
unnamed: D3.4 (BK), U6.9 (NC3)
unnamed: D3.1 (RK), U6.5 (NC2)
unnamed: U1.D1 (LED1_DRV), U6.16 (COM1)
unnamed: U1.C1 (LED2_DRV), U6.4 (COM2)
unnamed: U1.B1 (LED3_DRV), U6.8 (COM3)
unnamed: D4.1, D4.2, D4.3, D4.4, D4.6, D4.7, D4.8, U1.D5 (PD1_IN)
unnamed: D6.1, D6.2, D6.3, D6.4, D6.6, D6.7, D6.8, U1.D4 (PD2_IN)
unnamed: C4.1, U1.B5 (VREF)
PD_GND: D4.5, D6.5, JP1.1 (A), U1.C5 (PD_GND)
SCL: MT1.13 (AP_SCL/AP_SCLK); also elsewhere on the board
SDA: MT1.14 (AP_SDA/AP_SDIO/AP_SDI); also elsewhere on the board

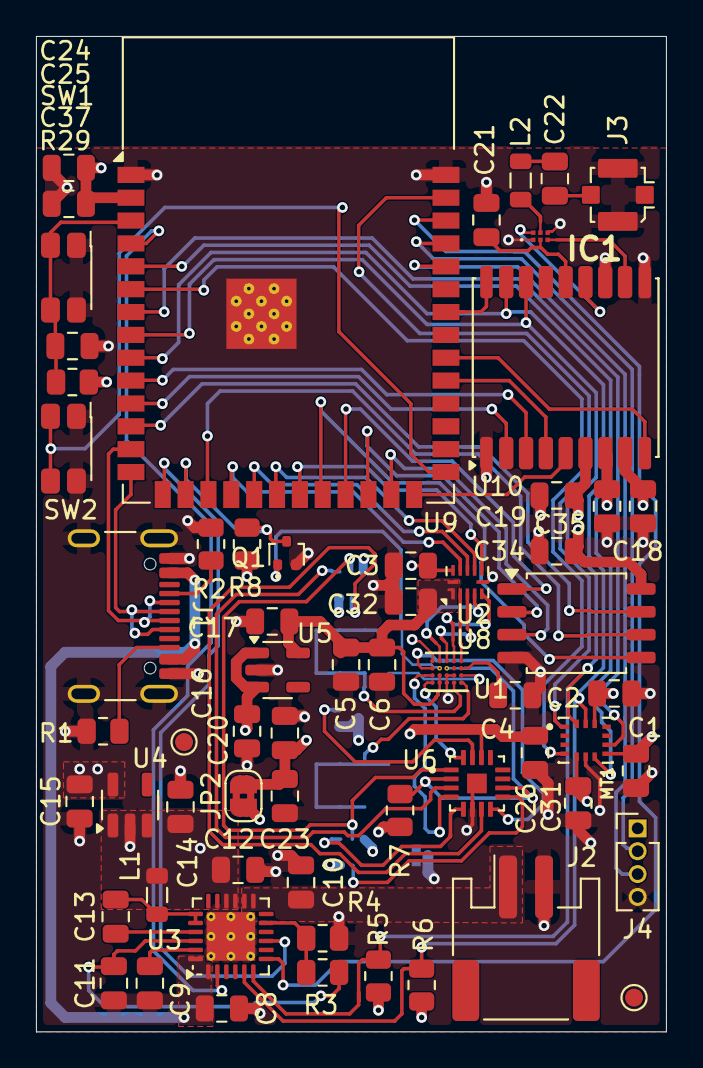
[picture p6: board horsesense.kicad_pcb from above]

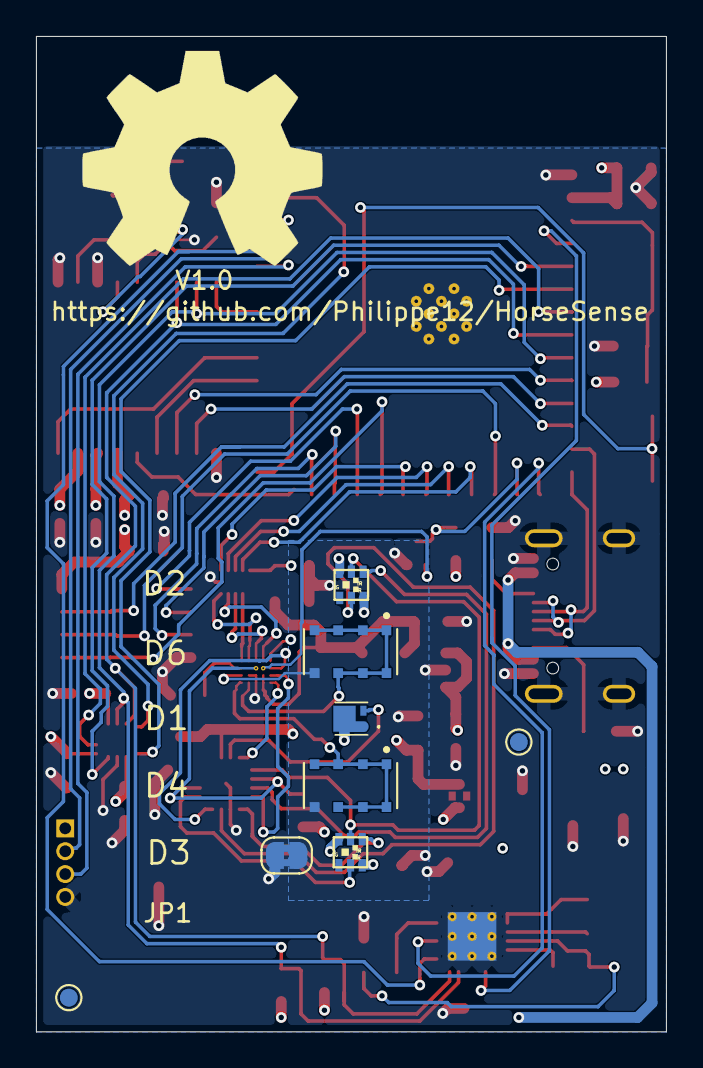
[picture p7: board horsesense.kicad_pcb from below]

Board: 4 copper layers, 35.0 x 55.3 mm, 71 parts (9 on the bottom side), 71 nets.
