Philippe12/HorseSense/(commit log)

2025-09-20 Add power rail
    Battery charger
    3.3V LDO
    1.8V LDO
    [mcu.kicad_sch, power.kicad_sch]
2025-10-19 Routage complet
    [bom.csv, capteur.kicad_sch, designators.csv, gps.kicad_sch, horsesense.kicad_pcb, horsesense.kicad_sch, mcu.kicad_sch, positions.csv]
2025-10-19 Add UFL connector 3D
    [horsesense.kicad_pcb]
2025-10-19 Set MPN
    [bom.csv, capteur.kicad_sch, gps.kicad_sch, horsesense.kicad_pcb, mcu.kicad_sch, positions.csv, power.kicad_sch]
2025-10-19 Change Code for JLC part
    [capteur.kicad_sch, gps.kicad_sch, mcu.kicad_sch, power.kicad_sch]
2025-10-19 JLC code chage
    [bom.csv, capteur.kicad_sch, horsesense.csv, horsesense.kicad_pcb, horsesense.xlsx]
2025-11-01 Add Flash device
    [capteur.kicad_sch, gps.kicad_sch, horsesense.kicad_pcb, horsesense.xlsx, mcu.kicad_sch]
2025-11-01 Add mire and sizing marks
    [horsesense.kicad_pcb, horsesense.kicad_sch]
2025-11-01 Ass logo
    [horsesense.kicad_pcb, horsesense.kicad_sch]
2025-11-01 Add version
    [capteur.kicad_sch, gps.kicad_sch, horsesense.kicad_pcb, horsesense.kicad_sch, mcu.kicad_sch, power.kicad_sch]
2025-11-01 production file
    [BOM-horsesense.csv, bom.csv, designators.csv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]
2025-11-01 3D export
    [capteur.kicad_sch, horsesense.kicad_pcb]
2025-11-02 Change GNSS device
    [capteur.kicad_sch, gps.kicad_sch, horsesense.kicad_pcb, horsesense.kicad_sch, mcu.kicad_sch, power.kicad_sch]
2025-11-23 Update for JLC parts
    [capteur.kicad_sch, gps.kicad_sch, horsesense.kicad_pcb, horsesense.kicad_sch, mcu.kicad_sch, power.kicad_sch]
2025-11-23 Production files
    [BOM-horsesense.csv, bom.csv, designators.csv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]
2025-12-23 Add red and IR LED for capter
    [capteur.kicad_sch, gps.kicad_sch, horsesense.kicad_pcb, horsesense.kicad_sch, mcu.kicad_sch, power.kicad_sch]
2025-12-23 Update 3D
    [horsesense.kicad_pcb]
2025-12-23 Add battery connecter
    [capteur.kicad_sch, gps.kicad_sch, horsesense.kicad_pcb, horsesense.kicad_sch, mcu.kicad_sch, power.kicad_sch]
2025-12-23 export 3D board
2025-12-23 jlcpcb production part
    [BOM-horsesense.csv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]
2026-01-04 some PCB correction
    [BOM-horsesense.csv, bom.csv, capteur.kicad_sch, gps.kicad_sch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]
2026-02-14 add data into map
    [horsesense-CuBottom.gbr, horsesense-CuIn1.gbr, horsesense-CuIn2.gbr, horsesense-CuTop.gbr, horsesense-EdgeCuts.gbr, horsesense-MaskBottom.gbr, horsesense-MaskTop.gbr, horsesense-NPTH.drl]
2026-02-21 PCP correction CAO fitback
    [horsesense.csv, horsesense.kicad_pcb]
2026-02-21 JLC production file update
    [horsesense-CuBottom.gbr, horsesense-CuIn1.gbr, horsesense-CuIn2.gbr, horsesense-CuTop.gbr, horsesense-EdgeCuts.gbr, horsesense-MaskBottom.gbr, horsesense-MaskTop.gbr, horsesense-NPTH.drl]
2026-02-21 Adjust C8 placement and refresh Gerbers
    Correct the placement of capacitor C8 in jlcpcb/production_files/CPL-horsesense.csv (coords changed from 15.1,1.47 to 14.375,1.255) and update jlcpcb/production_files/GERBER-horsesense.zip so the production files match the updated placement.
    [CPL-horsesense.csv]
2026-02-21 Update PCB netlist and component positions
    Apply coordinate and net-mapping corrections for production PCB files: update production/netlist.ipc with numerous via coordinate adjustments and corrected net/instance entries (3.3V, GND, VBUS, VSYS, I2C, GPS, FLASH, etc.). Adjust component placement in production/positions.csv (C8 coordinate tweak). Replace production/HorseSense_1.0.zip (binary) to match these layout fixes for manufacturing.
    [positions.csv]
2026-02-22 Correction from feedback jlcpcb
    [CPL-horsesense.csv, horsesense-CuBottom.gbr, horsesense-CuIn1.gbr, horsesense-CuIn2.gbr, horsesense-CuTop.gbr, horsesense-EdgeCuts.gbr, horsesense-MaskBottom.gbr, horsesense-MaskTop.gbr]
2026-02-22 net correction
    [horsesense.kicad_pcb]
2026-02-24 Change for µVia in pad
    [horsesense.kicad_pcb]
2026-08-13 reduce board size
    [BOM-horsesense.csv, bom.csv, capteur.kicad_sch, designators.csv, gps.kicad_sch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]
